kaibader/Audio-Interface/Rev_2.0/audio_interface.pdf

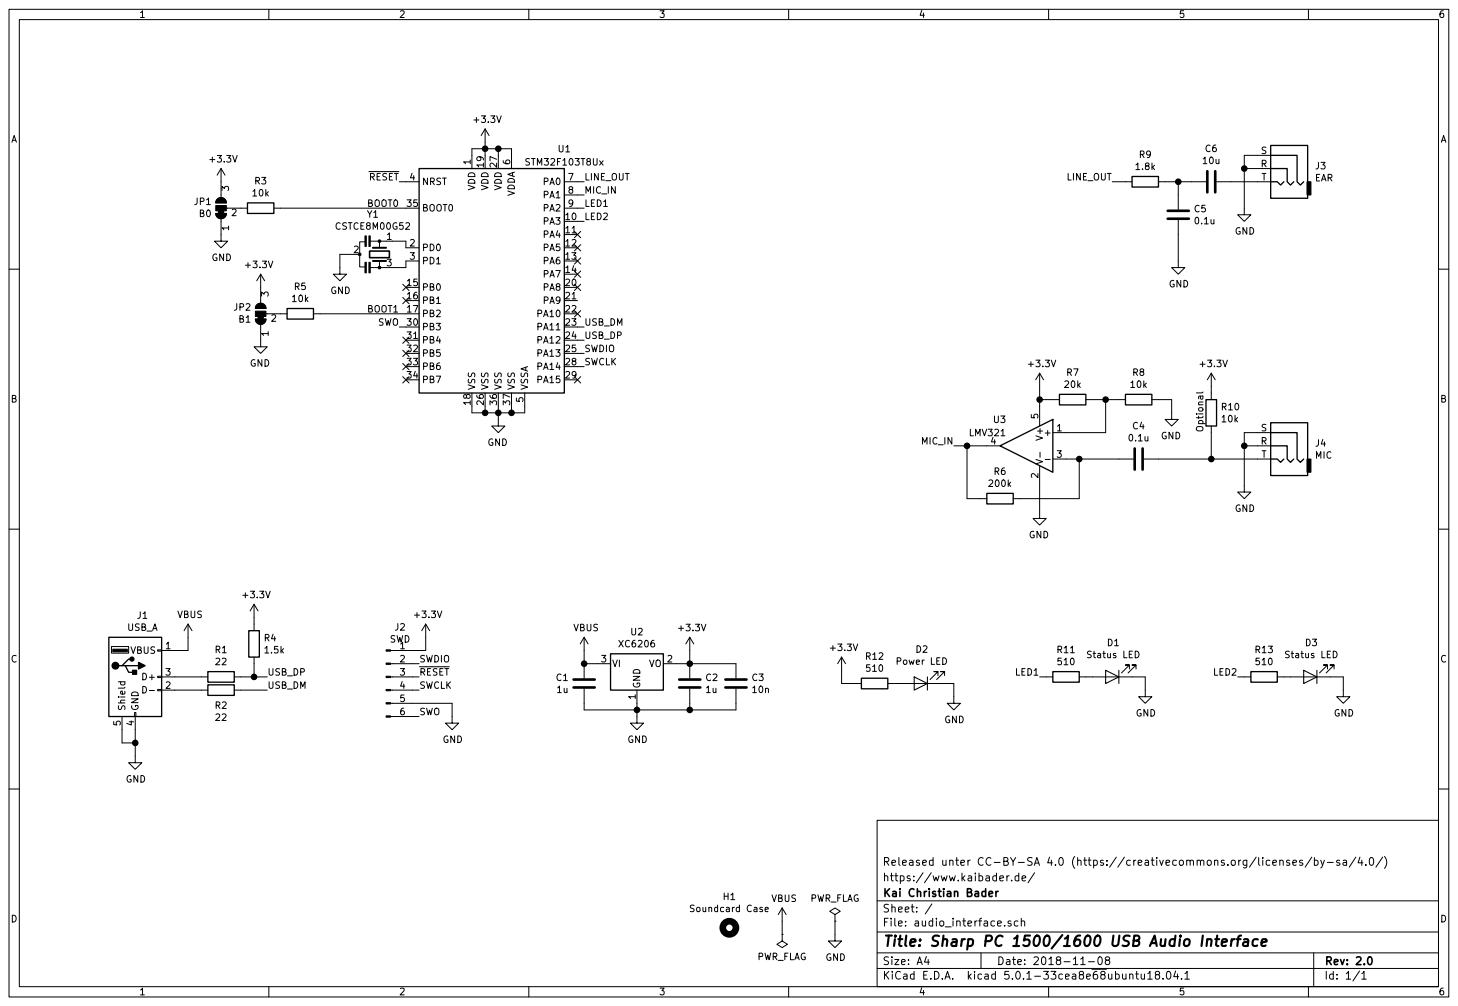
[picture p1: page 1]

6 VSS 18 VSS 26 VSS 36 VSS 37 VSSA

File: audio_interface.sch Sheet: / Kai Christian Bader https://www.kaibader.de/

Id: 1/1 Title: Sharp PC 1500/1600 USB Audio Interface
