kaibader/Audio-Interface/Rev_1.1/audio_interface.pdf

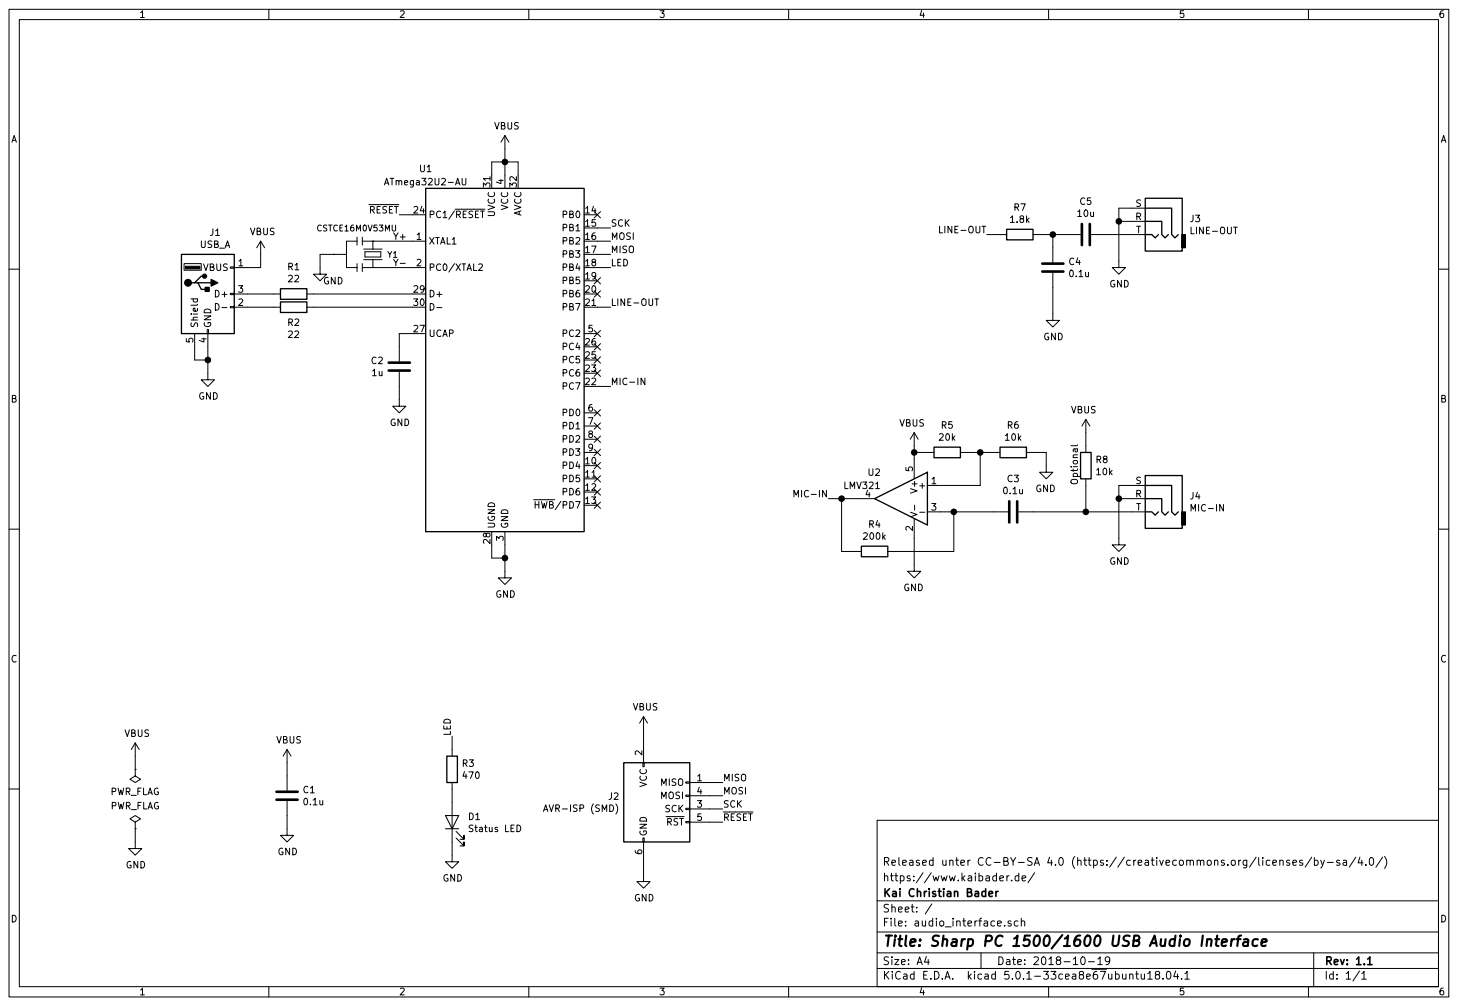
[picture p2: page 1]

LINE-OUT SCK MOSI MISO
LED MIC-IN

10k VBUS Optional MOSI MISO

2 SCK 3 MOSI 4 RST 5 GND

Released unter CC-BY-SA 4.0 (https://creativecommons.org/licenses/by-sa/4.0/)
File: audio_interface.sch Sheet: / Kai Christian Bader https://www.kaibader.de/

Id: 1/1 Title: Sharp PC 1500/1600 USB Audio Interface
