kaibader/Audio-Interface/Rev_1.0/audio_interface.pdf

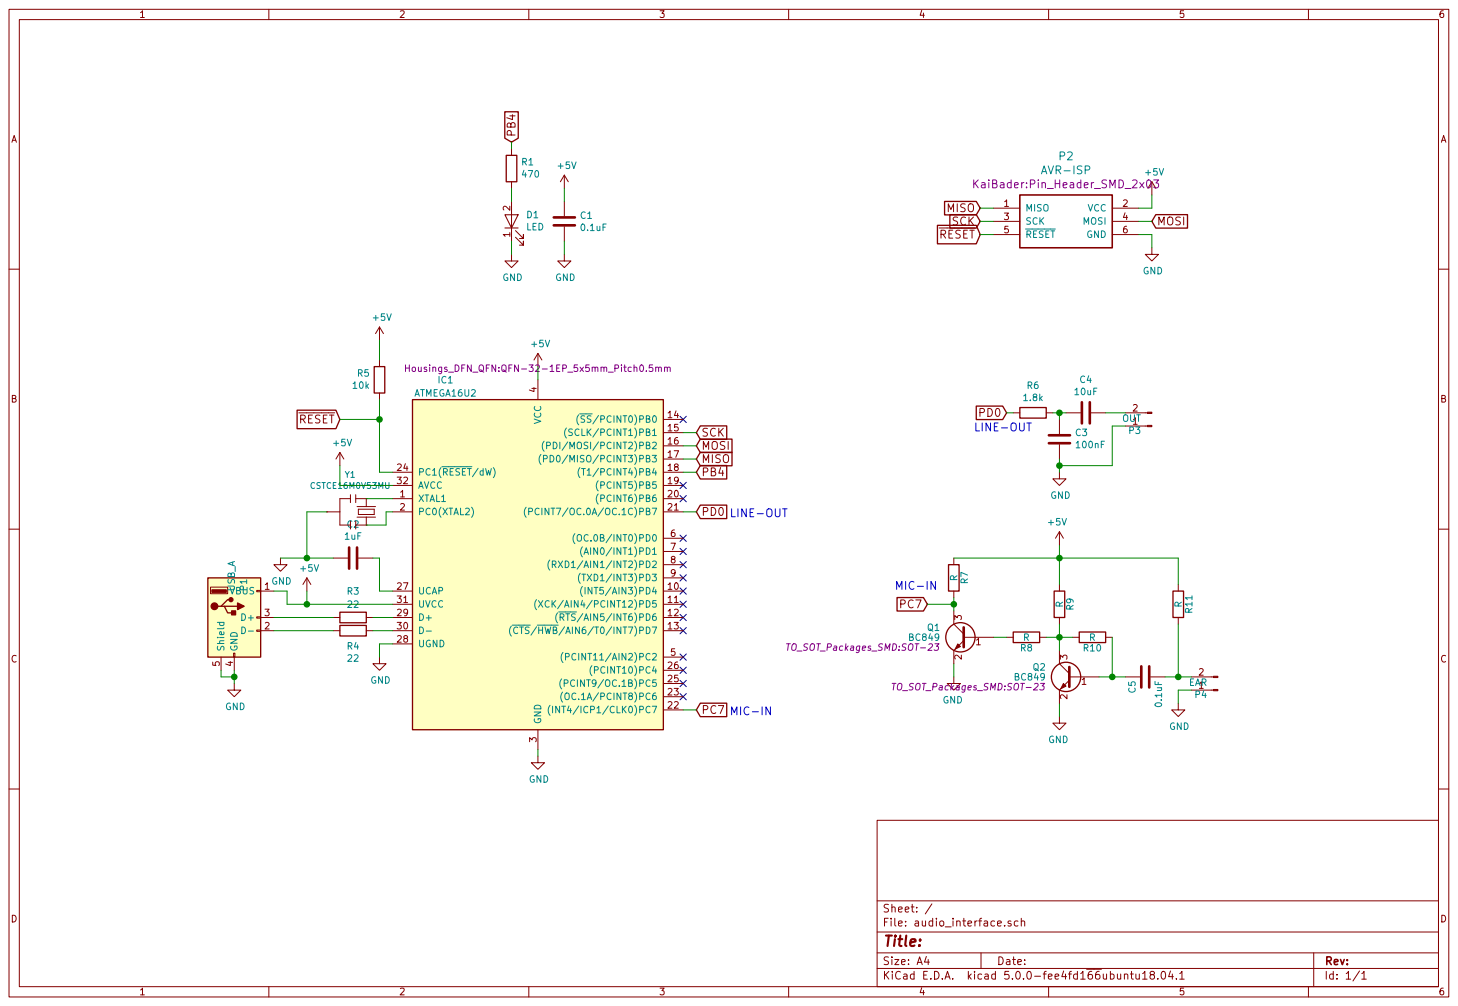
[picture p3: page 1]
