kaibader/Audio-Interface/LTspice/cmt-out-4.asc

C1: cap; 4.7n
C2: cap; 0.1µ
C3: cap; 0.01µ
C4: cap; 10µ
R1: res; 18k
R2: res; 10k
R3: res; 270
R4: res; 270
R5: res; 1k
R6: res; 10k
R7: res; 10k
R8: res; 10k
R9: res; 47k
U1: lm358
V1: voltage; PULSE(0 5 0 0.01u 0.01u 0.000195313 0.000390625)
V2: voltage; 5
Named nets: 0, MIC, SIGNAL
.tran 0.01s
