kaibader/Audio-Interface/LTspice/mic-in.asc

C1: cap; 4.7n
C2: cap; 0.1µ
C3: cap; 0.01µ
R1: res; 18k
R2: res; 18k
R3: res; 10k
R4: res; 270
R5: res; 270
V1: voltage; PULSE(0 5 0.05 0.01u 0.01u 0.000195313 0.000390625 240)
V2: voltage; PULSE(0 5 0 0.01u 0.01u 0.000416666 0.000833333 60)
Named nets: 0, PULSE, MIC
.tran 0.1
