kaibader/Audio-Interface/LTspice/interface/line-out_simulation_3.asc

C1: cap; 0.1µ
C2: cap; 10µ
R1: res; 1.8k
R2: res; 1k
R3: res; 1k
V1: voltage; PULSE(0 3.3 0 0.01u 0.01u 0.00019685 0.000393701)
V2: voltage; 5
Named nets: 0, Signal, LINE_OUT
.tran 50mS
