kaibader/Audio-Interface/LTspice/interface/mic-in_simulation_4.asc

A2: buf; Vhigh=3.3 Vlow=0 Ref=1.2
C1: cap; 4.7n
C2: cap; 0.1µ
C3: cap; 0.01µ
C4: cap; 0.1µ
R1: res; 18k
R2: res; 10k
R3: res; 270
R4: res; 270
R5: res; 20k
R6: res; 200k
R7: res; 10k
R8: res; 10k
U1: LMV358
V1: voltage; PULSE(0 5 0 0.01u 0.01u 0.000195313 0.000390625)
V2: voltage; 3.3
Named nets: 0, MIC, TO_ATMEGA, Signal, VDD
.tran 10mS
