kaibader/Audio-Interface/LTspice/ce150/ce150-line-in_via_sig_gen.asc

A1: buf; Vhigh=5 Vlow=0 Ref=1.5
A2: buf; Vhigh=5 Vlow=0 Ref=1.5
C1: cap; 0.047µF
C2: cap; 0.1µF
C3: cap; 10µF
R1: res; 100k
R2: res; 1k
R3: res; 1Meg
R4: res; 1.8k
V1: voltage; PULSE(0 5 0 0.01u 0.01u 0.00019685 0.000393701)
Named nets: CMTIN, LINE, 0, SIGNAL
.tran 50ms
.options gmin=1e-5
.options cshunt=5e-8
Sharp CE-150 LINE-IN
Audio Interface LINE-OUT
