kaibader/Audio-Interface/LTspice/ce150/ce150-line-in_via_wave.asc

A1: buf; Vhigh=5 Vlow=0 Ref=1.5
A2: buf; Vhigh=5 Vlow=0 Ref=1.5
C1: cap; 0.047µF
R1: res; 100k
R2: res; 1k
R3: res; 1Meg
V1: voltage; wavefile=test.wav
Named nets: CMTIN, LINE_IN, 0
.tran 100ms
.options gmin=1e-5
.options cshunt=5e-8
