kaibader/Audio-Interface/LTspice/interface/line-out_simulation_2.asc

C1: cap; 0.1µ
C2: cap; 10µ
C3: cap; 0.1µ
R1: res; 1k
R2: res; 1k
R3: res; 1k
V1: voltage; PULSE(0 5 0 0.01u 0.01u 0.00019685 0.000393701)
Named nets: 0, Signal, LINE_OUT
.tran 50mS
