kaibader/Audio-Interface/LTspice/interface/lmv358.asc

C1: cap; 100nF
C2: cap; 100nF
R1: res; 10k
R2: res; 100k
R4: res; 15k
R5: res; 10k
U2: LMV358
V1: voltage; SINE(0 10mV 2450)
V2: voltage; 5V
Named nets: 0
.tran 20mS
