kaibader/Audio-Interface/LTspice/interface/line-out_simulation_1.asc

C1: cap; 0.1µF
C2: cap; 10µF
R1: res; 1.8k
R2: res; 1k
V1: voltage; PULSE(0 5 0 0.01u 0.01u 0.00019685 0.000393701)
Named nets: 0, Signal, LINE_OUT
.tran 50mS
