kaibader/Audio-Interface/LTspice/interface/mic-in_simulation_1.asc

A2: buf; Vhigh=5 Vlow=0 Ref=1.5
C1: cap; 4.7n
C2: cap; 0.1µ
C3: cap; 0.01µ
C4: cap; 0.1µ
Q1: npn; BC847C
Q2: npn; BC847C
R1: res; 18k
R2: res; 10k
R3: res; 270
R4: res; 270
R5: res; 100k
R6: res; 10k
R7: res; 10k
R8: res; 470
R9: res; 10k
V1: voltage; PULSE(0 5 0 0.01u 0.01u 0.000195313 0.000390625)
V2: voltage; 5
Named nets: 0, MIC, TO_ATMEGA, Signal
.tran 0.01s
