kaibader/Audio-Interface/audio_interface.kicad_pcb

## KiCad design audio_interface.kicad_pcb (2018-11-08)

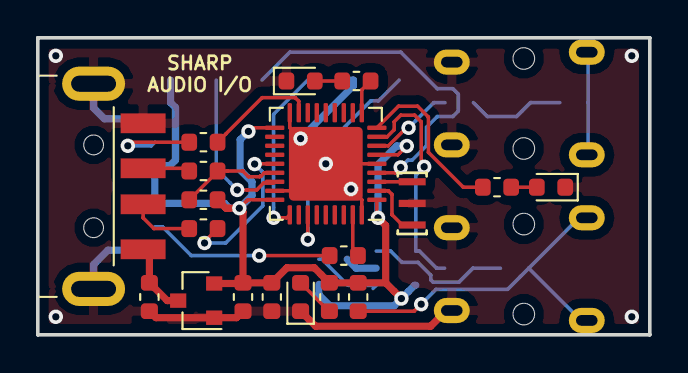
[picture p4: board audio_interface.kicad_pcb from above]

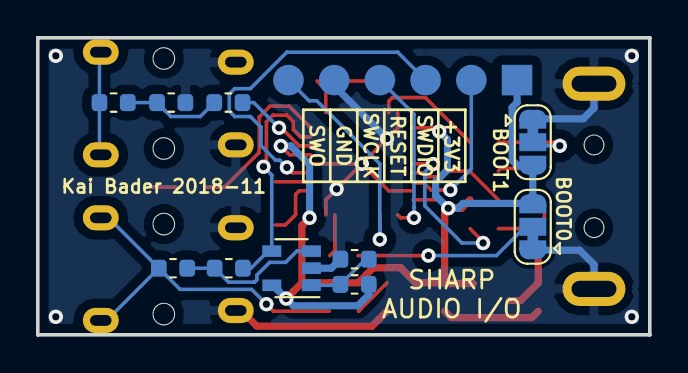
[picture p5: board audio_interface.kicad_pcb from below]

Board: 2 copper layers, 34.0 x 16.5 mm, 33 parts (11 on the bottom side), 29 nets.

Parts:
C1, C2: 1u; C_0603_1608Metric
C3: 10n; C_0603_1608Metric
C4, C5: 0.1u; C_0603_1608Metric
C6: 10u; C_0603_1608Metric
D1, D3: Status LED; LED_0603_1608Metric
D2: Power LED; LED_0603_1608Metric
H1: Soundcard Case; USB_Soundcard_Case
J1: USB_A; USB-A-Connector
J2: SWD; PinHeader_SMD_1x06
J3: EAR; Audio_Jack_3.5mm_Horizontal
J4: MIC; Audio_Jack_3.5mm_Horizontal
JP1: B0; SolderJumper-3_P1.3mm_Bridged12_RoundedPad1.0x1.5mm
JP2: B1; SolderJumper-3_P1.3mm_Bridged12_RoundedPad1.0x1.5mm
R1, R2: 22; R_0603_1608Metric
R3, R5, R8, R10: 10k; R_0603_1608Metric
R4: 1.5k; R_0603_1608Metric
R6: 200k; R_0603_1608Metric
R7: 20k; R_0603_1608Metric
R9: 1.8k; R_0603_1608Metric
R11, R12, R13: 510; R_0603_1608Metric
U1: STM32F103T8Ux; QFN-36-1EP_6x6mm_P0.5mm_EP4.1x4.1mm
U2: XC6206; SOT-23
U3: LMV321; SOT-23-5
Y1: CSTCE8M00G52

Connections:
+3V3: C2.1, C3.1, J2.1, JP1.3, JP2.3, R4.1, R7.1, R10.1, R12.2, U1.1, U1.6, U1.19, U1.27, U2.2, U3.5
/BOOT0: R3.1, U1.35
/BOOT1: R5.2, U1.17
/LED1: R11.2, U1.9
/LED2: R13.2, U1.10
/LINE_OUT: R9.2, U1.7
/MIC_IN: R6.1, U1.8, U3.4
/SWCLK: J2.4, U1.28
/SWDIO: J2.2, U1.25
/SWO: J2.6, U1.30
/USB_DM: R2.1, U1.23
/USB_DP: R1.1, R4.2, U1.24
/~RESET: J2.3, U1.4
GND: C1.2, C2.2, C3.2, C5.2, D1.1, D2.1, D3.1, J1.4, J1.5, J2.5, J3.R, J3.S, J4.R, J4.S, JP1.1, JP2.1, R8.2, U1.5, U1.18, U1.26, U1.36, U1.37, U2.1, U3.2, Y1.2
unnamed: C4.1, R6.2, U3.3
unnamed: C4.2, J4.T, R10.2
unnamed: C5.1, C6.2, R9.1
unnamed: C6.1, J3.T
unnamed: D1.2, R11.1
unnamed: D2.2, R12.1
unnamed: D3.2, R13.1
unnamed: J1.2, R2.2
unnamed: J1.3, R1.2
unnamed: JP1.2, R3.2
unnamed: JP2.2, R5.1
unnamed: R7.2, R8.1, U3.1
unnamed: U1.2, Y1.1
unnamed: U1.3, Y1.3
VBUS: C1.1, J1.1, U2.3
