kaibader/Audio-Interface/(commit log)

2016-04-13 Created a new KiCAD project for my 'Sharp PC-1500 Audio Interface'
    [audio_interface.kicad_pcb, audio_interface.sch]
2016-04-13 Panelized PCB. Added Gerber files.
    [audio_interface_double.kicad_pcb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]
2017-05-25 Added (part cache) library
    [audio_interface.sch]
2018-09-07 Moved/Saved the current state of the project into a v1.0 folder for documentation purposes.
    - Exported the Symbols into a separate lib for backup reasons.
    - Imported the project from KiCad v4 into KiCad v5 (as good as possible).
    - Updated the ignore list.
    [audio_interface.kicad_pcb, audio_interface.sch, audio_interface_double.kicad_pcb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]
2018-09-20 Various changes / refactoring.
    - Updated the schematic due to KiCad 5 changes.
    - Reorganized the directories to allow better version control.
    - Cleaned up the LTspice files and created new ones (better fitting ones) for the Sharp PC-1500.
    [audio_interface.kicad_pcb, audio_interface.sch]
2018-10-17 Squashed commit. Worked on an Rev_1.1 Audio Interface with various changes/updates.
    [audio_interface.kicad_pcb, audio_interface.sch]
2018-10-19 Moved v1.0 to Rev_1.0
    [audio_interface.kicad_pcb, audio_interface.sch, audio_interface_double.kicad_pcb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]
2018-10-19 Rev_1.1 Preparation
    [audio_interface.sch]
2018-10-23 Revision Clean-Up
    [audio_interface.drl, audio_interface.gbl, audio_interface.gbo, audio_interface.gbs, audio_interface.gm1, audio_interface.gtl, audio_interface.gto, audio_interface.gts]
2018-11-08 Rev 2.0 based on an STM32F103 microcontroller.
    [audio_interface.kicad_pcb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]
